turbovanya/HMS-esp32s3/docs/images/lost.png

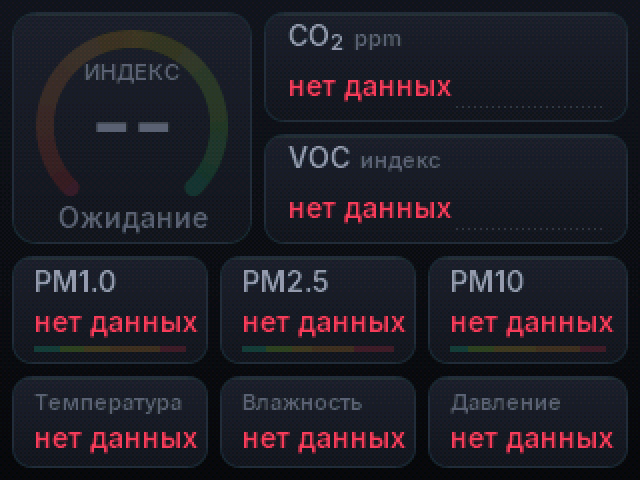
docs/images/lost.png
