turbovanya/HMS-esp32s3/docs/images/warmup.png

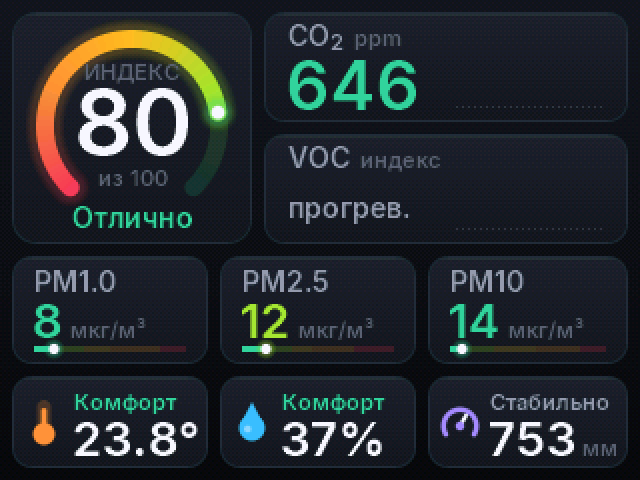
docs/images/warmup.png
