turbovanya/HMS-esp32s3/docs/COMPONENTS.md

# Компоненты HMS и их характеристики

[Главная проекта](../README.md) · [Схема подключения](HARDWARE.md) · [Прошивка](../MeteoStation/MeteoStation.ino)

HMS измеряет параметры воздуха в помещении. В таблице указаны напряжения **в схеме HMS**, а в карточках ниже — паспортные параметры компонентов. Точность измерений в собранной станции зависит от монтажа, вентиляции корпуса и условий работы.

| Компонент | Назначение | Подключение в HMS | Питание |
| --- | --- | --- | --- |
| [ESP32-S3](#esp32-s3--контроллер) | Опрос датчиков, расчёт индекса, графика | USB, SPI, I²C и два UART | Через USB платы |
| [ST7789V](#st7789v--дисплей) | Цветной экран 320 × 240 | SPI, 40 МГц | 3,3 В |
| [SHT40](#sht40--температура-и-влажность) | Температура и относительная влажность | I²C · `0x44` | 3,3 В |
| [BMP280](#bmp280--атмосферное-давление) | Атмосферное давление | I²C · `0x76` | 3,3 В |
| [SGP40](#sgp40--индекс-voc) | Изменения уровня летучих органических соединений | I²C · `0x59` | 3,3 В |
| [MH-Z19B](#mh-z19b--концентрация-co₂) | Концентрация углекислого газа | UART2 · 9600, 8N1 | 5 В |
| [PMS7003](#pms7003--взвешенные-частицы) | PM1.0, PM2.5 и PM10 | UART1 · 9600, 8N1 | 5 В |

## ESP32-S3 — контроллер

- **Микроконтроллер.** Два ядра Xtensa LX7 с частотой до 240 МГц, 512 КБ внутренней SRAM. Чип поддерживает Wi-Fi 2,4 ГГц и Bluetooth LE.
- **Конфигурация HMS.** 240 МГц, 4 МБ flash, PSRAM отключена. Экран и расчёты работают локально. В текущей прошивке радиоинтерфейсы не используются.
- **При выборе платы.** Проверьте наличие USB с передачей данных и доступность всех GPIO из схемы. GPIO35–37 на некоторых вариантах заняты памятью.

[Характеристики Espressif](https://www.espressif.com/products/socs/esp32-s3) · [Ограничения GPIO](HARDWARE.md#что-понадобится)

## ST7789V — дисплей

- **Панель.** Цветной TFT-модуль 240 × 320 с контроллером Sitronix ST7789V. HMS поворачивает изображение горизонтально до 320 × 240.
- **Передача кадра.** Аппаратный SPI на 40 МГц по настройке прошивки. Цвет кодируется в RGB565, по 16 бит на пиксель.
- **При выборе модуля.** Нужен SPI-вариант с выведенными CS, DC и RST. Диагональ, напряжение и ток подсветки проверяйте по паспорту конкретного модуля.

[Паспорт контроллера Sitronix](https://support.newhavendisplay.com/hc/en-us/articles/4414907838487-ST7789V) · [Контакты дисплея](HARDWARE.md#дисплей-st7789v)

## SHT40 — температура и влажность

- **Диапазоны.** От −40 до +125 °C и от 0 до 100 % относительной влажности.
- **Типичная точность.** ±0,2 °C и ±1,8 процентного пункта относительной влажности в условиях, указанных Sensirion. Питание микросхемы 1,08–3,6 В.
- **В HMS.** Прошивка читает датчик примерно каждые 2 с. Сглаженные значения попадают на экран и передаются SGP40 для компенсации. Для измерения комнатной температуры размещайте SHT40 ближе к вентиляционным отверстиям и вдали от нагрева платы.

[Характеристики Sensirion SHT40](https://sensirion.com/products/catalog/SHT40)

## BMP280 — атмосферное давление

- **Диапазон давления.** 300–1100 гПа. Типичная абсолютная точность ±1 гПа при 950–1050 гПа и 0…+40 °C.
- **Интерфейс.** Микросхема поддерживает I²C и SPI. HMS использует I²C с адресом `0x76`. Питание VDD микросхемы 1,71–3,6 В.
- **В HMS.** Измерение примерно каждые 2 с. Прошивка переводит показания в мм рт. ст. и рассчитывает тренд за 3 часа. На экране показано давление в месте установки.

[Паспорт Bosch BMP280](https://www.bosch-sensortec.com/media/boschsensortec/downloads/datasheets/bst-bmp280-ds001.pdf)

## SGP40 — индекс VOC

- **Принцип.** Чувствительный слой на нагреваемой подложке реагирует на летучие органические соединения. Датчик передаёт сырой сигнал, из которого алгоритм Sensirion вычисляет индекс.
- **Шкала.** Рабочие значения индекса от 1 до 500. Значение около 100 соответствует привычному уровню по оценке алгоритма. Индекс относительный и не выражается в ppm. Питание микросхемы 1,7–3,6 В.
- **В HMS.** Опрос примерно раз в секунду при доступных показаниях SHT40. Нулевой результат во время инициализации алгоритма прошивка пропускает. На экране есть график за час.

[Паспорт Sensirion SGP40](https://sensirion.com/resource/datasheet/sgp40) · [Алгоритм Sensirion](https://github.com/Sensirion/gas-index-algorithm)

## MH-Z19B — концентрация CO₂

- **Принцип.** NDIR, измерение поглощения инфракрасного света углекислым газом. Результат в ppm.
- **Диапазон и точность.** Паспорт Winsen описывает варианты до 2 000, 5 000 и 10 000 ppm. Сверьте диапазон своего экземпляра по маркировке. Паспортная погрешность ±(50 ppm + 5 % показания).
- **Питание и отклик.** 4,5–5,5 В, пиковый ток до 150 мА при 5 В. Логика UART 3,3 В. Прогрев около 3 минут, время отклика T90 менее 120 с.
- **В HMS.** Прошивка отправляет запрос `0x86` каждые 5 с и проверяет контрольную сумму ответа. Частота опроса не ускоряет физический отклик датчика.

[Руководство Winsen MH-Z19B, версия 1.6](https://www.winsen-sensor.com/d/files/infrared-gas-sensor/ndir-co2-sensor/mh-z19b-co2-manual%28ver1_6%29.pdf)

## PMS7003 — взвешенные частицы

- **Принцип.** Вентилятор протягивает воздух через оптическую камеру. По рассеянию лазерного света модуль оценивает концентрацию частиц. Минимальный различимый размер по паспорту 0,3 мкм.
- **Диапазон и разрешение.** Для стандартного канала PM2.5 Plantower указывает эффективный диапазон 0–500 мкг/м³ с шагом 1 мкг/м³. Межприборное расхождение в этом канале указано как ±10 мкг/м³ до 100 мкг/м³ и ±10 % в диапазоне 100–500 мкг/м³.
- **Питание и габариты.** 4,5–5,5 В, ток в активном режиме до 100 мА, логика UART 3,3 В. Корпус 48 × 37 × 12 мм.
- **В HMS.** Модуль передаёт кадры самостоятельно. Прошивка читает поля PM1.0, PM2.5 и PM10 для атмосферного воздуха и проверяет контрольную сумму. При монтаже оставьте свободными оба вентиляционных отверстия датчика.

[Паспорт Plantower PMS7003, версия 2.5](https://download.kamami.pl/p564008-PMS7003%20series%20data%20manua_English_V2.5.pdf)

## Питание, провода и корпус

| Что понадобится | Как подобрать |
| --- | --- |
| Источник 5 В | По паспортам два UART-датчика могут потребовать суммарно до 250 мА. При питании всей сборки от одного источника учтите также ESP32-S3, дисплей, подсветку и остальные датчики |
| Линия 3,3 В | Для дисплея и трёх модулей I²C. Проверьте допустимый ток стабилизатора платы по её схеме |
| USB-кабель | С передачей данных, чтобы прошивать плату и использовать монитор порта |
| Шлейф PMS7003 | На 10 контактов под конкретный разъём или через переходник. Ориентацию и номера контактов проверьте по паспорту |
| Провода и корпус | Общий GND, короткие линии к SPI-дисплею, свободный проход воздуха к датчикам |

[Распиновка, питание и первый запуск →](HARDWARE.md)
