turbovanya/HMS-esp32s3/(commit log)

2026-11-04 Опубликовать прошивку HMS для ESP32-S3
2026-11-04 Оформить руководство по сборке и схему подключения HMS
2026-11-04 Добавить справочник по датчикам и компонентам HMS
2026-11-04 Оформить главную страницу HMS для посетителей
2026-11-04 Обновить ссылки на новый адрес HMS
